jarojuda/SinglePair-Ethernet-Gateway/hardware/SinglePair-Eth-Gateway/SinglePair-Eth-Gateway.kicad_pcb

## KiCad design hardware/SinglePair-Eth-Gateway/SinglePair-Eth-Gateway.kicad_pcb (2024-01-26)

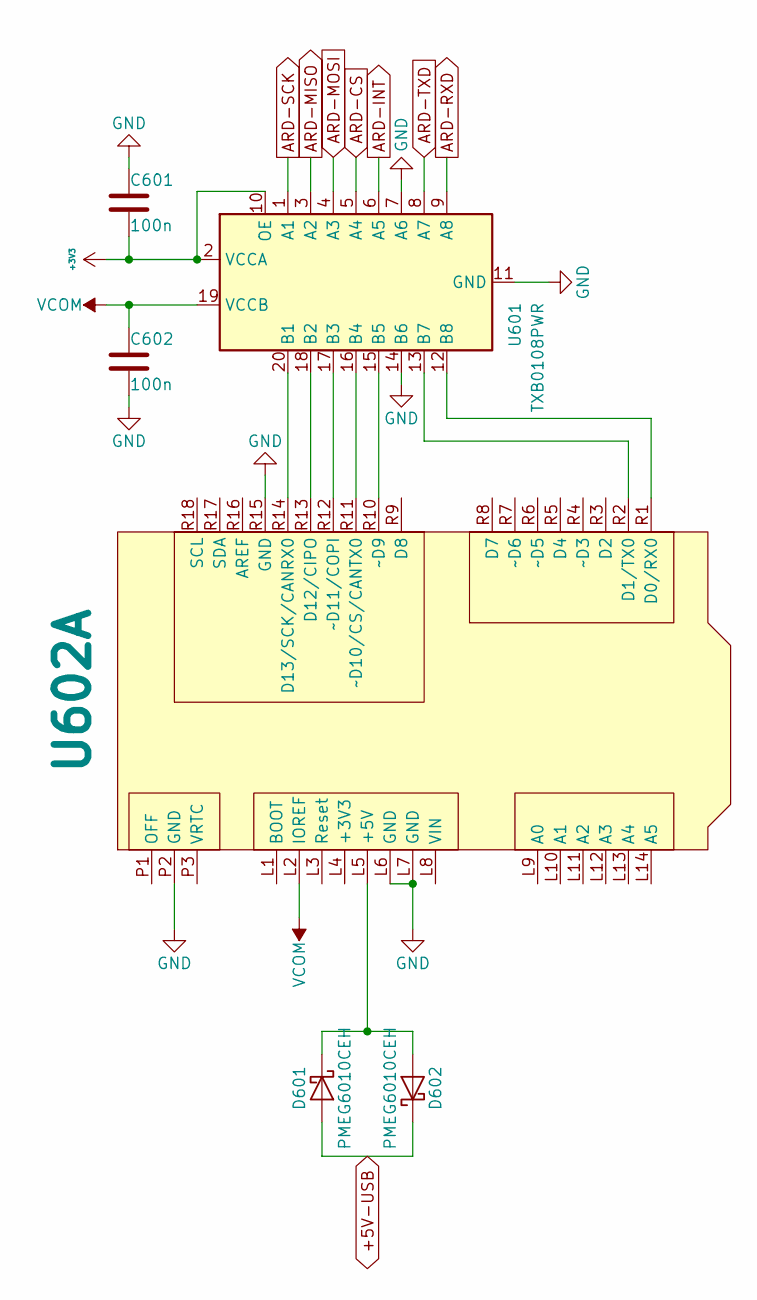
[picture p1: schematic Arduino.kicad_sch]

Parts:
C601, C602: 100n; C_0603_1608Metric
D601, D602: PMEG6010CEH; D_SOD-123F
U601: TXB0108PWR; TSSOP-20_4.4x6.5mm_P0.65mm
U602: Arduino_UNO_3_Connectors

Connections:
+3V3: C601.2, U601.2 (VCCA), U601.10 (OE); also elsewhere on the board
+5V-USB: D601.2 (A), D602.1 (K); also elsewhere on the board
ARD-CS: U601.5 (A4); also elsewhere on the board
ARD-INT: U601.6 (A5); also elsewhere on the board
ARD-MISO: U601.3 (A2); also elsewhere on the board
ARD-MOSI: U601.4 (A3); also elsewhere on the board
ARD-RXD: U601.9 (A8); also elsewhere on the board
ARD-SCK: U601.1 (A1); also elsewhere on the board
ARD-TXD: U601.8 (A7); also elsewhere on the board
GND: C601.1, C602.2, U601.7 (A6), U601.11 (GND), U601.14 (B6), U602.L6 (GND), U602.L7 (GND), U602.P2 (GND), U602.R15 (GND); also elsewhere on the board
unnamed: D601.1 (K), D602.2 (A), U602.L5 (+5V)
unnamed: U601.20 (B1), U602.R14 (D13/SCK/CANRX0)
unnamed: U601.18 (B2), U602.R13 (D12/CIPO)
unnamed: U601.17 (B3), U602.R12 (~D11/COPI)
unnamed: U601.16 (B4), U602.R11 (~D10/CS/CANTX0)
unnamed: U601.15 (B5), U602.R10 (~D9)
unnamed: U601.13 (B7), U602.R2 (D1/TX0)
unnamed: U601.12 (B8), U602.R1 (D0/RX0)
VCOM: C602.1, U601.19 (VCCB), U602.L2 (IOREF)

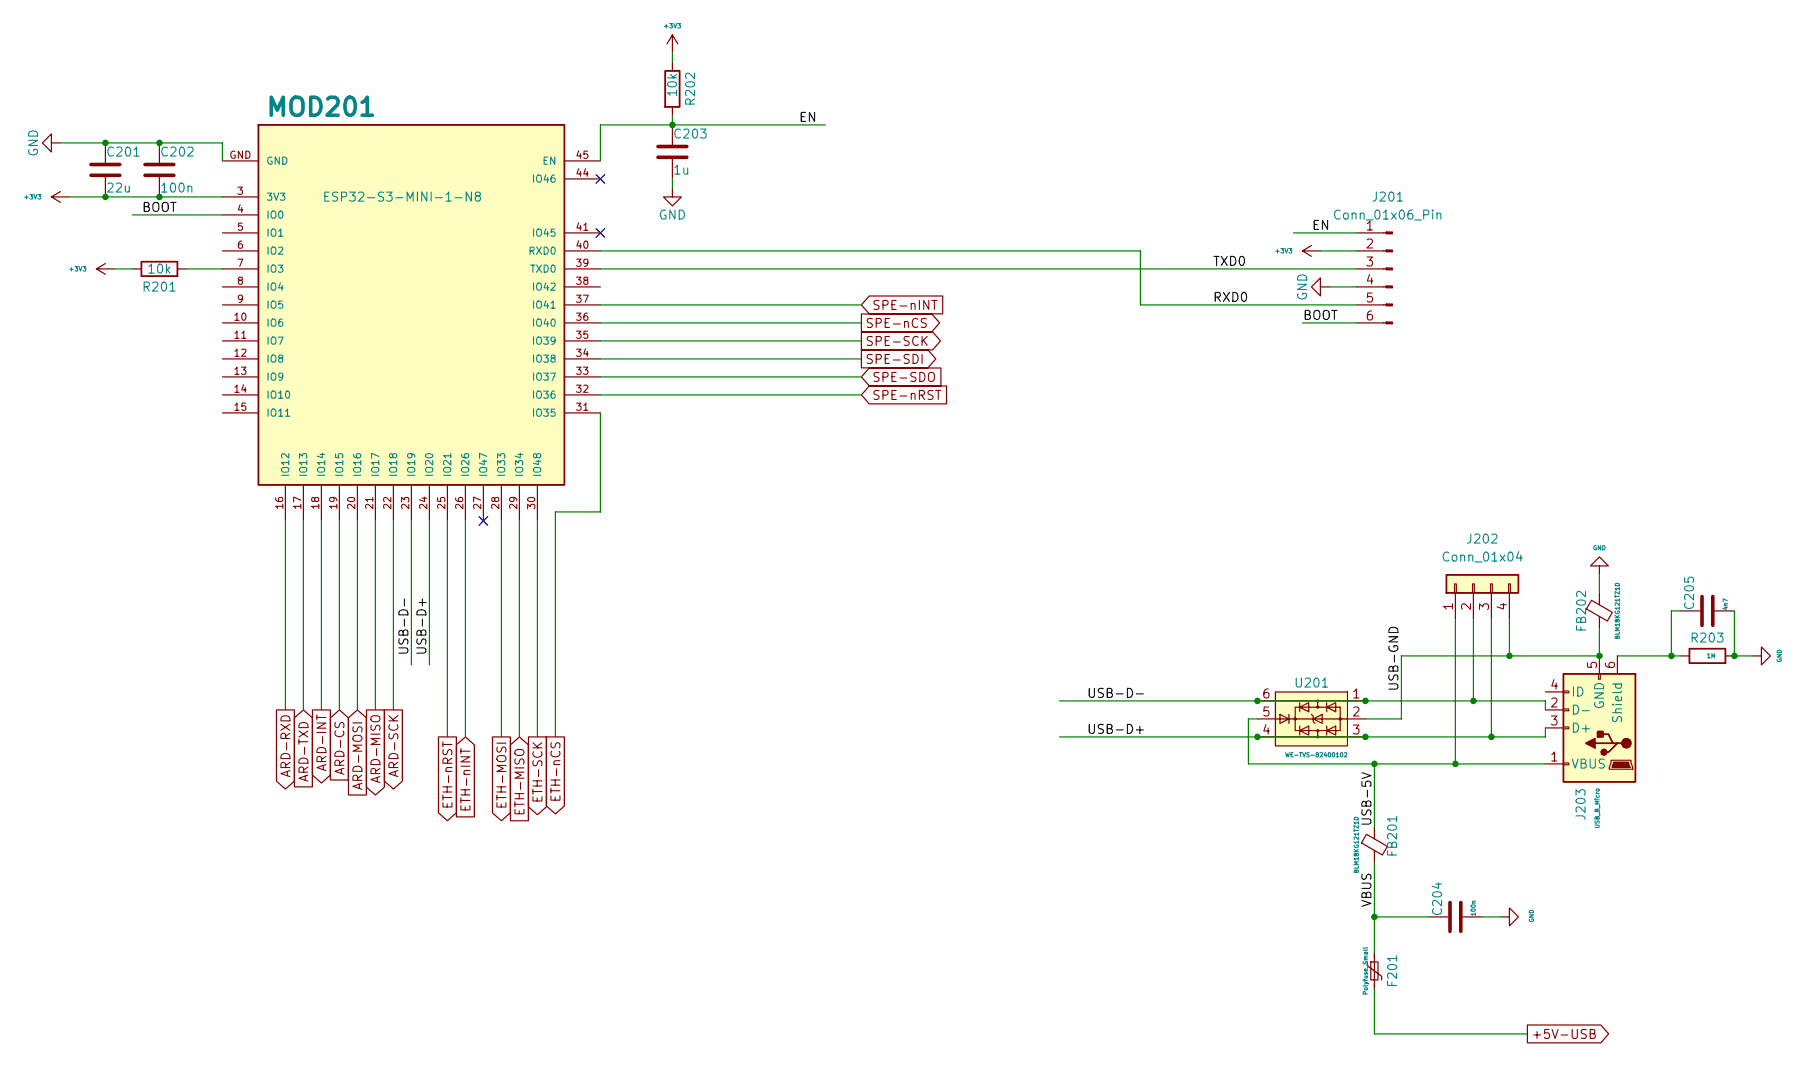
[picture p2: schematic ESP32-S3.kicad_sch]

Parts:
C201: 22u; C_0805_2012Metric
C202, C204: 100n; C_0603_1608Metric
C203: 1u; C_0603_1608Metric
C205: 4n7; C_0603_1608Metric
F201: Polyfuse_Small; Fuse_1210_3225Metric
FB201, FB202: BLM18KG121TZ1D; FB_0603_1608Metric
J201: Conn_01x06_Pin; PinHeader_1x06_P2.54mm_Vertical_SMD_Pin1Left
J202: Conn_01x04; PinSocket_1x04_P2.54mm_Vertical_SMD_Pin1Right
J203: USB_B_Micro; USB_Micro-B_Molex-105133-0001
MOD201: ESP32-S3-MINI-1-N8; XCVR_ESP32-S3-MINI-1-N8
R201, R202: 10k; R_0603_1608Metric
R203: 1M; R_0603_1608Metric
U201: WE-TVS-82400102; SOT-23-6

Connections:
+3V3: C201.2, C202.2, J201.2, MOD201.3 (3V3), R201.1, R202.1; also elsewhere on the board
+5V-USB: F201.2; also elsewhere on the board
/ESP32-S3/BOOT: J201.6, MOD201.4 (IO0)
/ESP32-S3/EN: C203.1, J201.1, MOD201.45 (EN), R202.2
/ESP32-S3/RXD0: J201.5, MOD201.40 (RXD0)
/ESP32-S3/TXD0: J201.3, MOD201.39 (TXD0)
/ESP32-S3/USB-5V: FB201.1, J202.1, J203.1 (VBUS), U201.5
/ESP32-S3/USB-D+: J202.3, J203.3 (D+), MOD201.24 (IO20), U201.3, U201.4
/ESP32-S3/USB-D-: J202.2, J203.2 (D-), MOD201.23 (IO19), U201.1, U201.6
/ESP32-S3/USB-GND: FB202.2, J202.4, J203.5 (GND), U201.2
/ESP32-S3/VBUS: C204.1, F201.1, FB201.2
ARD-CS: MOD201.19 (IO15); also elsewhere on the board
ARD-INT: MOD201.18 (IO14); also elsewhere on the board
ARD-MISO: MOD201.21 (IO17); also elsewhere on the board
ARD-MOSI: MOD201.20 (IO16); also elsewhere on the board
ARD-RXD: MOD201.16 (IO12); also elsewhere on the board
ARD-SCK: MOD201.22 (IO18); also elsewhere on the board
ARD-TXD: MOD201.17 (IO13); also elsewhere on the board
ETH-MISO: MOD201.29 (IO34); also elsewhere on the board
ETH-MOSI: MOD201.28 (IO33); also elsewhere on the board
ETH-SCK: MOD201.30 (IO48); also elsewhere on the board
ETH-nCS: MOD201.31 (IO35); also elsewhere on the board
ETH-nINT: MOD201.26 (IO26); also elsewhere on the board
ETH-nRST: MOD201.25 (IO21); also elsewhere on the board
GND: C201.1, C202.1, C203.2, C204.2, C205.2, FB202.1, J201.4, MOD201.GND, R203.2; also elsewhere on the board
unnamed: C205.1, J203.6 (Shield), R203.1
unnamed: MOD201.7 (IO3), R201.2
SPE-SCK: MOD201.35 (IO39); also elsewhere on the board
SPE-SDI: MOD201.34 (IO38); also elsewhere on the board
SPE-SDO: MOD201.33 (IO37); also elsewhere on the board
SPE-nCS: MOD201.36 (IO40); also elsewhere on the board
SPE-nINT: MOD201.37 (IO41); also elsewhere on the board
SPE-nRST: MOD201.32 (IO36); also elsewhere on the board

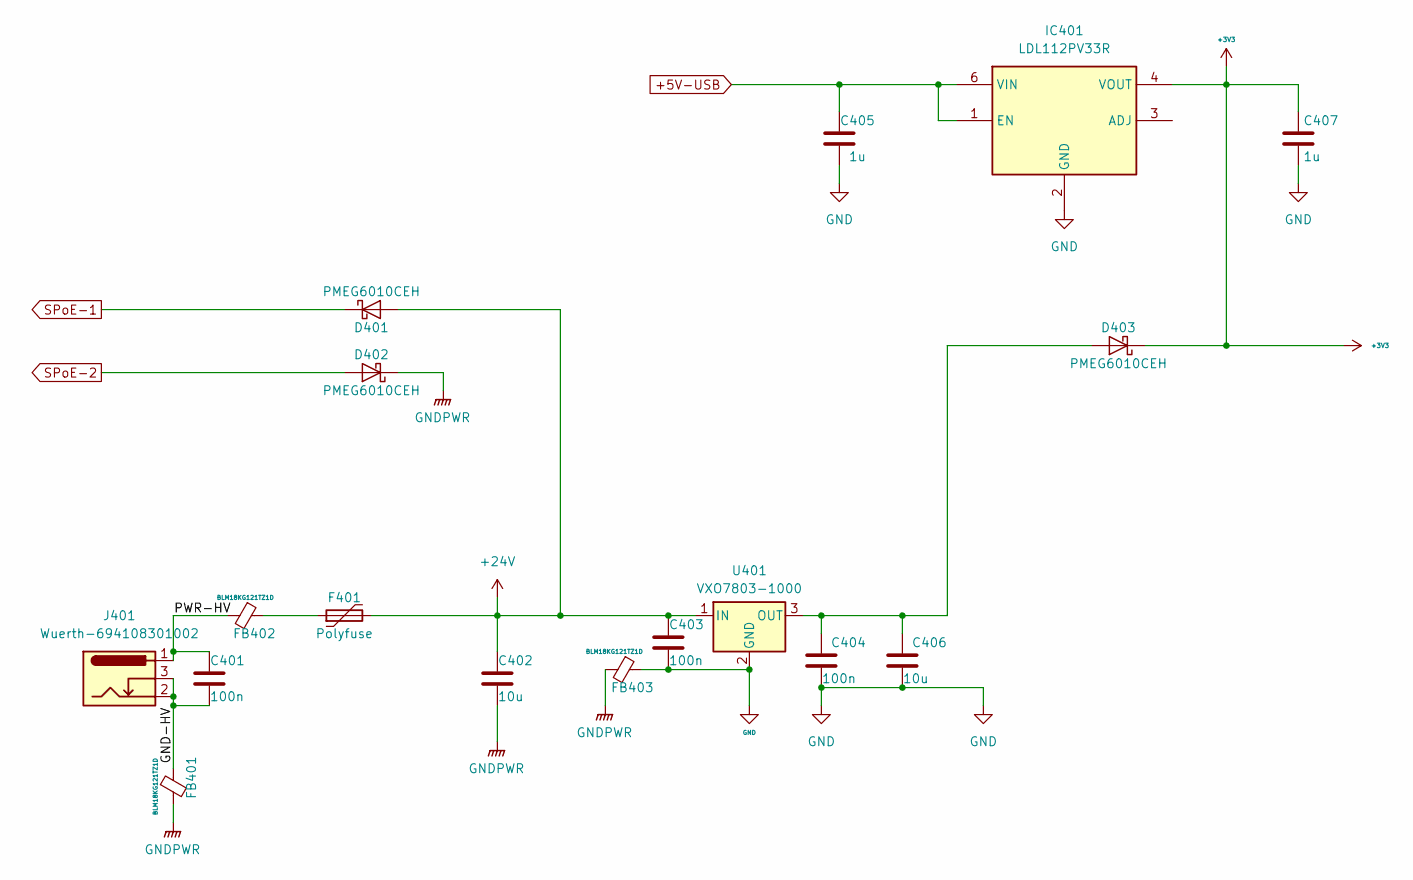
[picture p3: schematic PowerSupply.kicad_sch]

Parts:
C401, C403, C404: 100n; C_0603_1608Metric
C402, C406: 10u; C_0805_2012Metric
C405, C407: 1u; C_0603_1608Metric
D401, D402, D403: PMEG6010CEH; D_SOD-123F
F401: Polyfuse; Fuse_1210_3225Metric
FB401, FB402, FB403: BLM18KG121TZ1D; FB_0603_1608Metric
IC401: LDL112PV33R; SON95P300X300X100-7N-D; Manufacturer_Part_Number LDL112PV33R; Mouser Part Number 511-LDL112PV33R
J401: Wuerth-694108301002; BarrelJack_Wuerth_6941xx301002
U401: VXO7803-1000; TO-220-3_Vertical

Connections:
+3V3: C407.1, D403.1 (K), IC401.4 (VOUT); also elsewhere on the board
+5V-USB: C405.1, IC401.1 (EN), IC401.6 (VIN); also elsewhere on the board
+24V: C402.1, C403.1, D401.2 (A), F401.2, U401.1 (IN)
/PowerSupply/GND-HV: C401.2, FB401.1, J401.2, J401.3
/PowerSupply/PWR-HV: C401.1, FB402.2, J401.1
GND: C403.2, C404.2, C405.2, C406.2, C407.2, FB403.1, IC401.2 (GND), IC401.7 (EP), U401.2 (GND); also elsewhere on the board
GNDPWR: C402.2, D402.1 (K), FB401.2, FB403.2; also elsewhere on the board
unnamed: C404.1, C406.1, D403.2 (A), U401.3 (OUT)
unnamed: F401.1, FB402.1
SPoE-1: D401.1 (K); also elsewhere on the board
SPoE-2: D402.2 (A); also elsewhere on the board

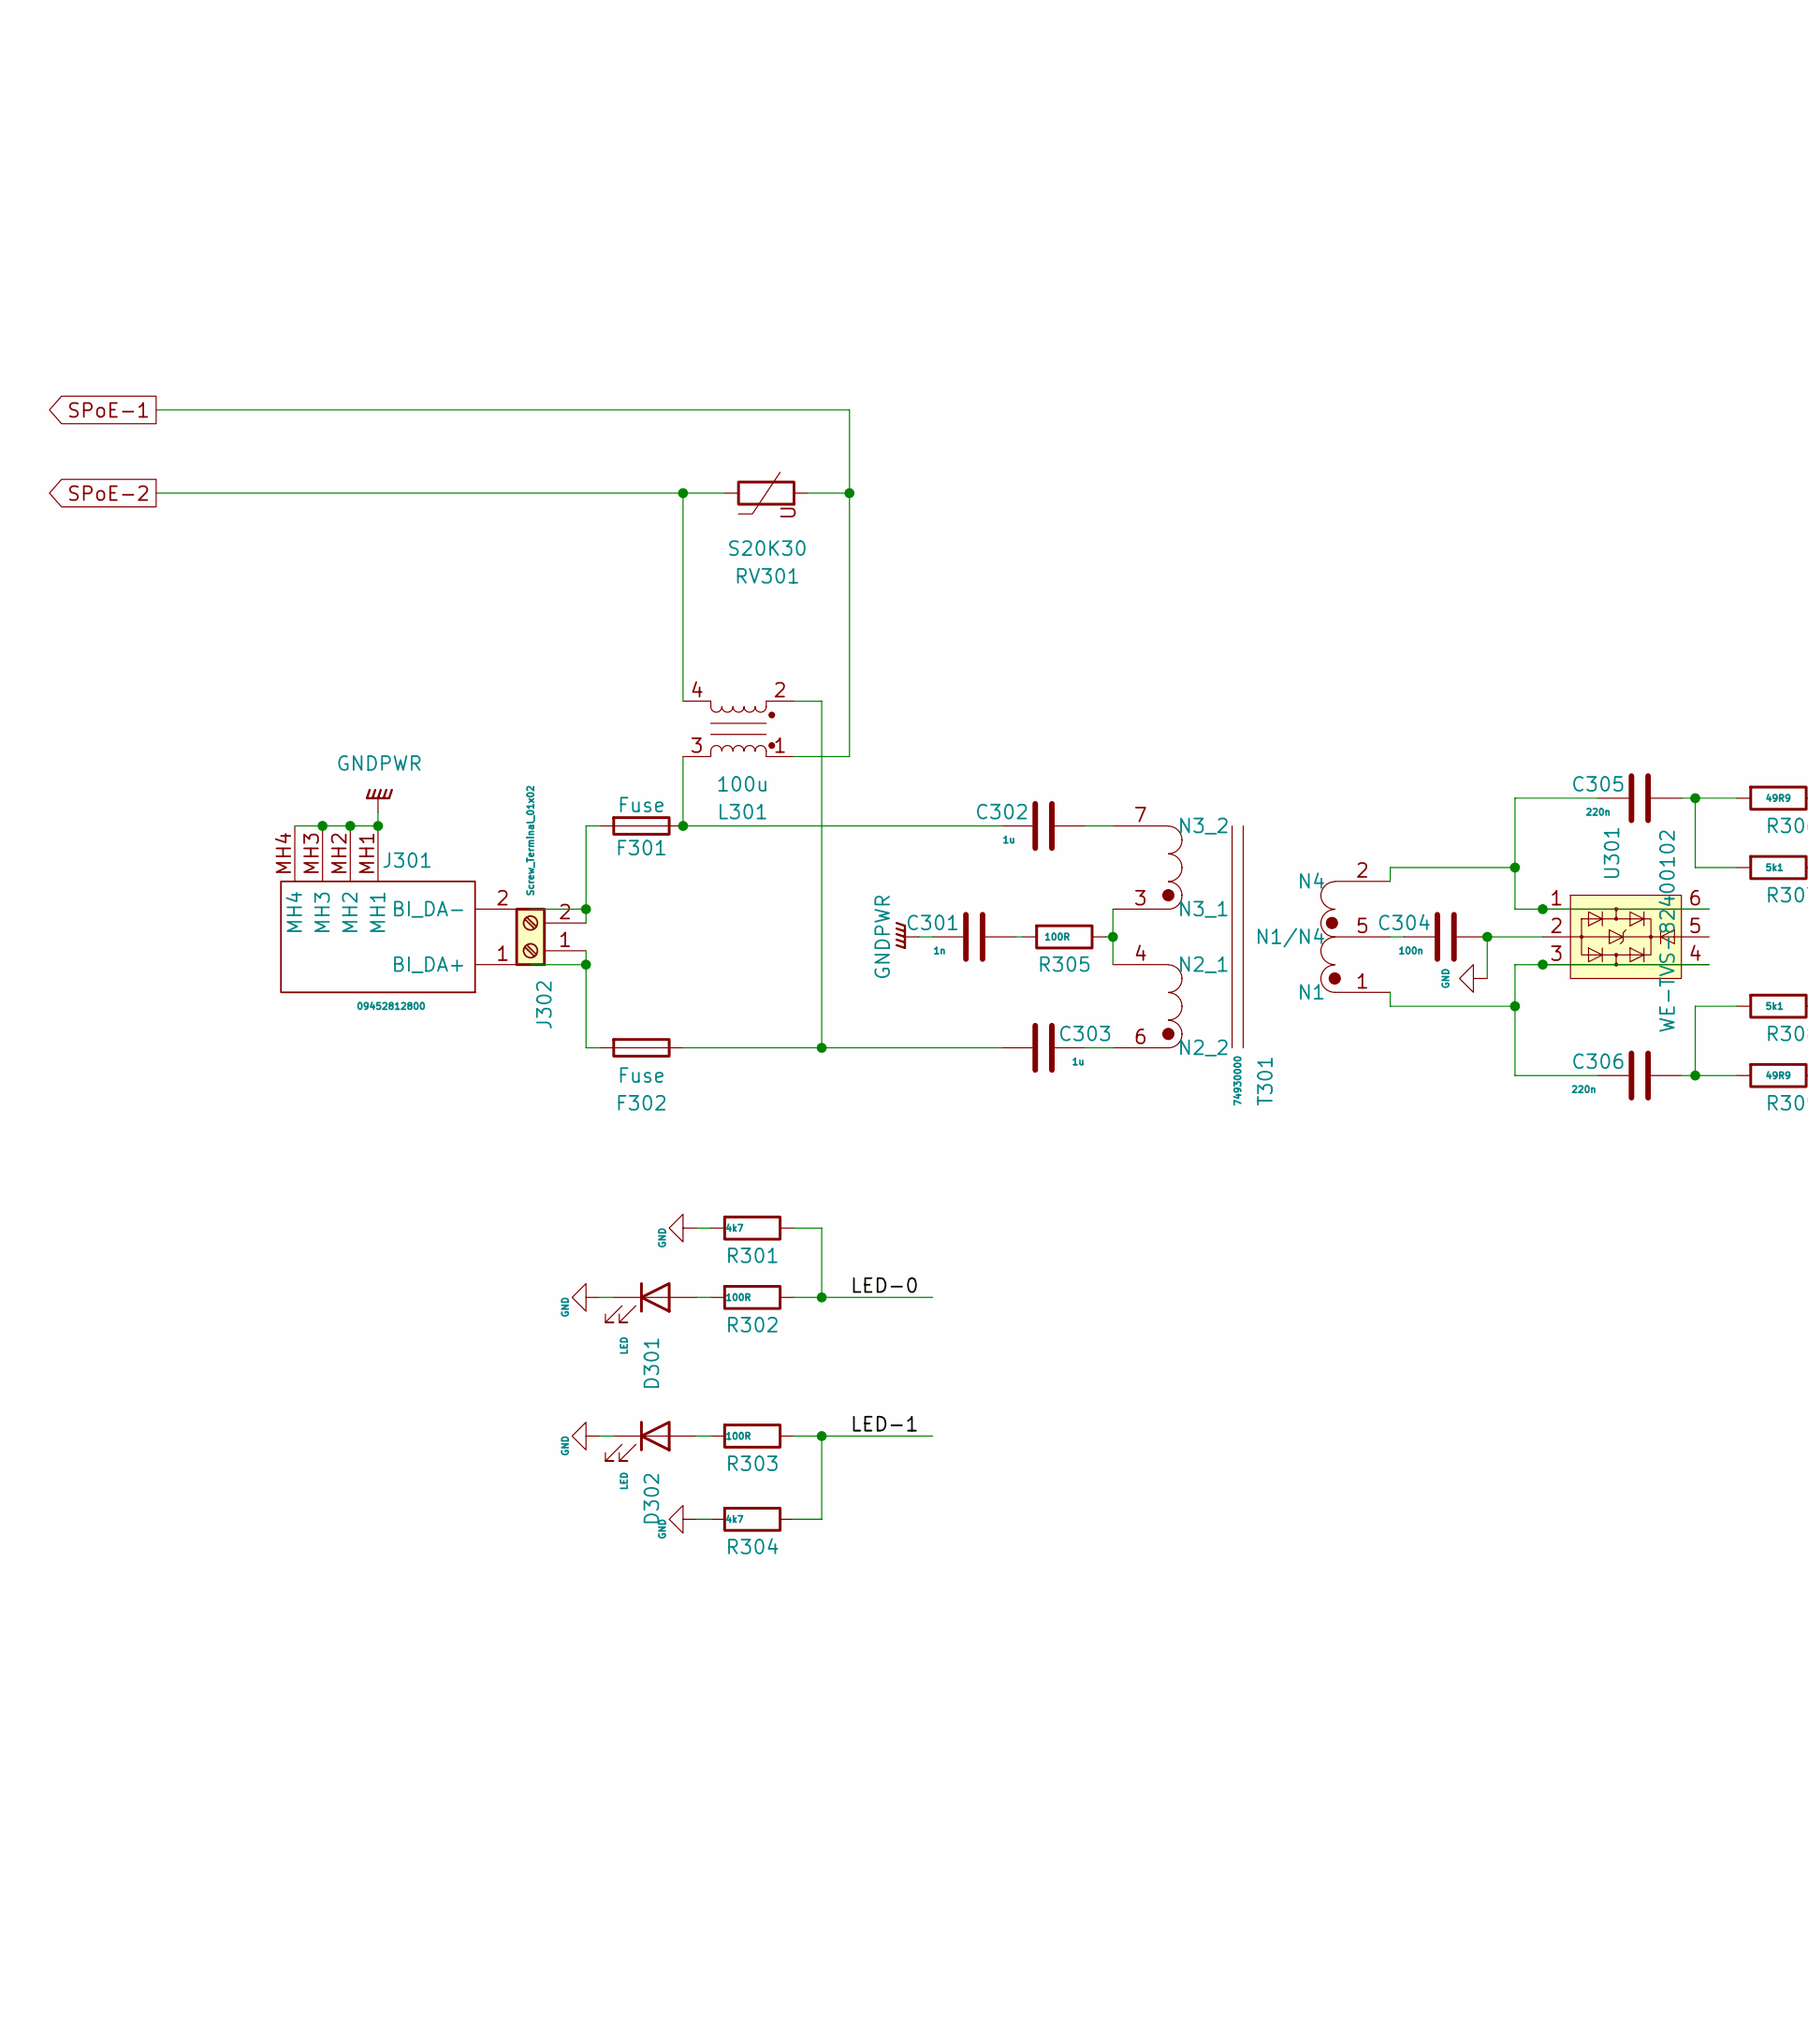
[picture p4: schematic ADIN1110.kicad_sch, part in row 1, column 1]

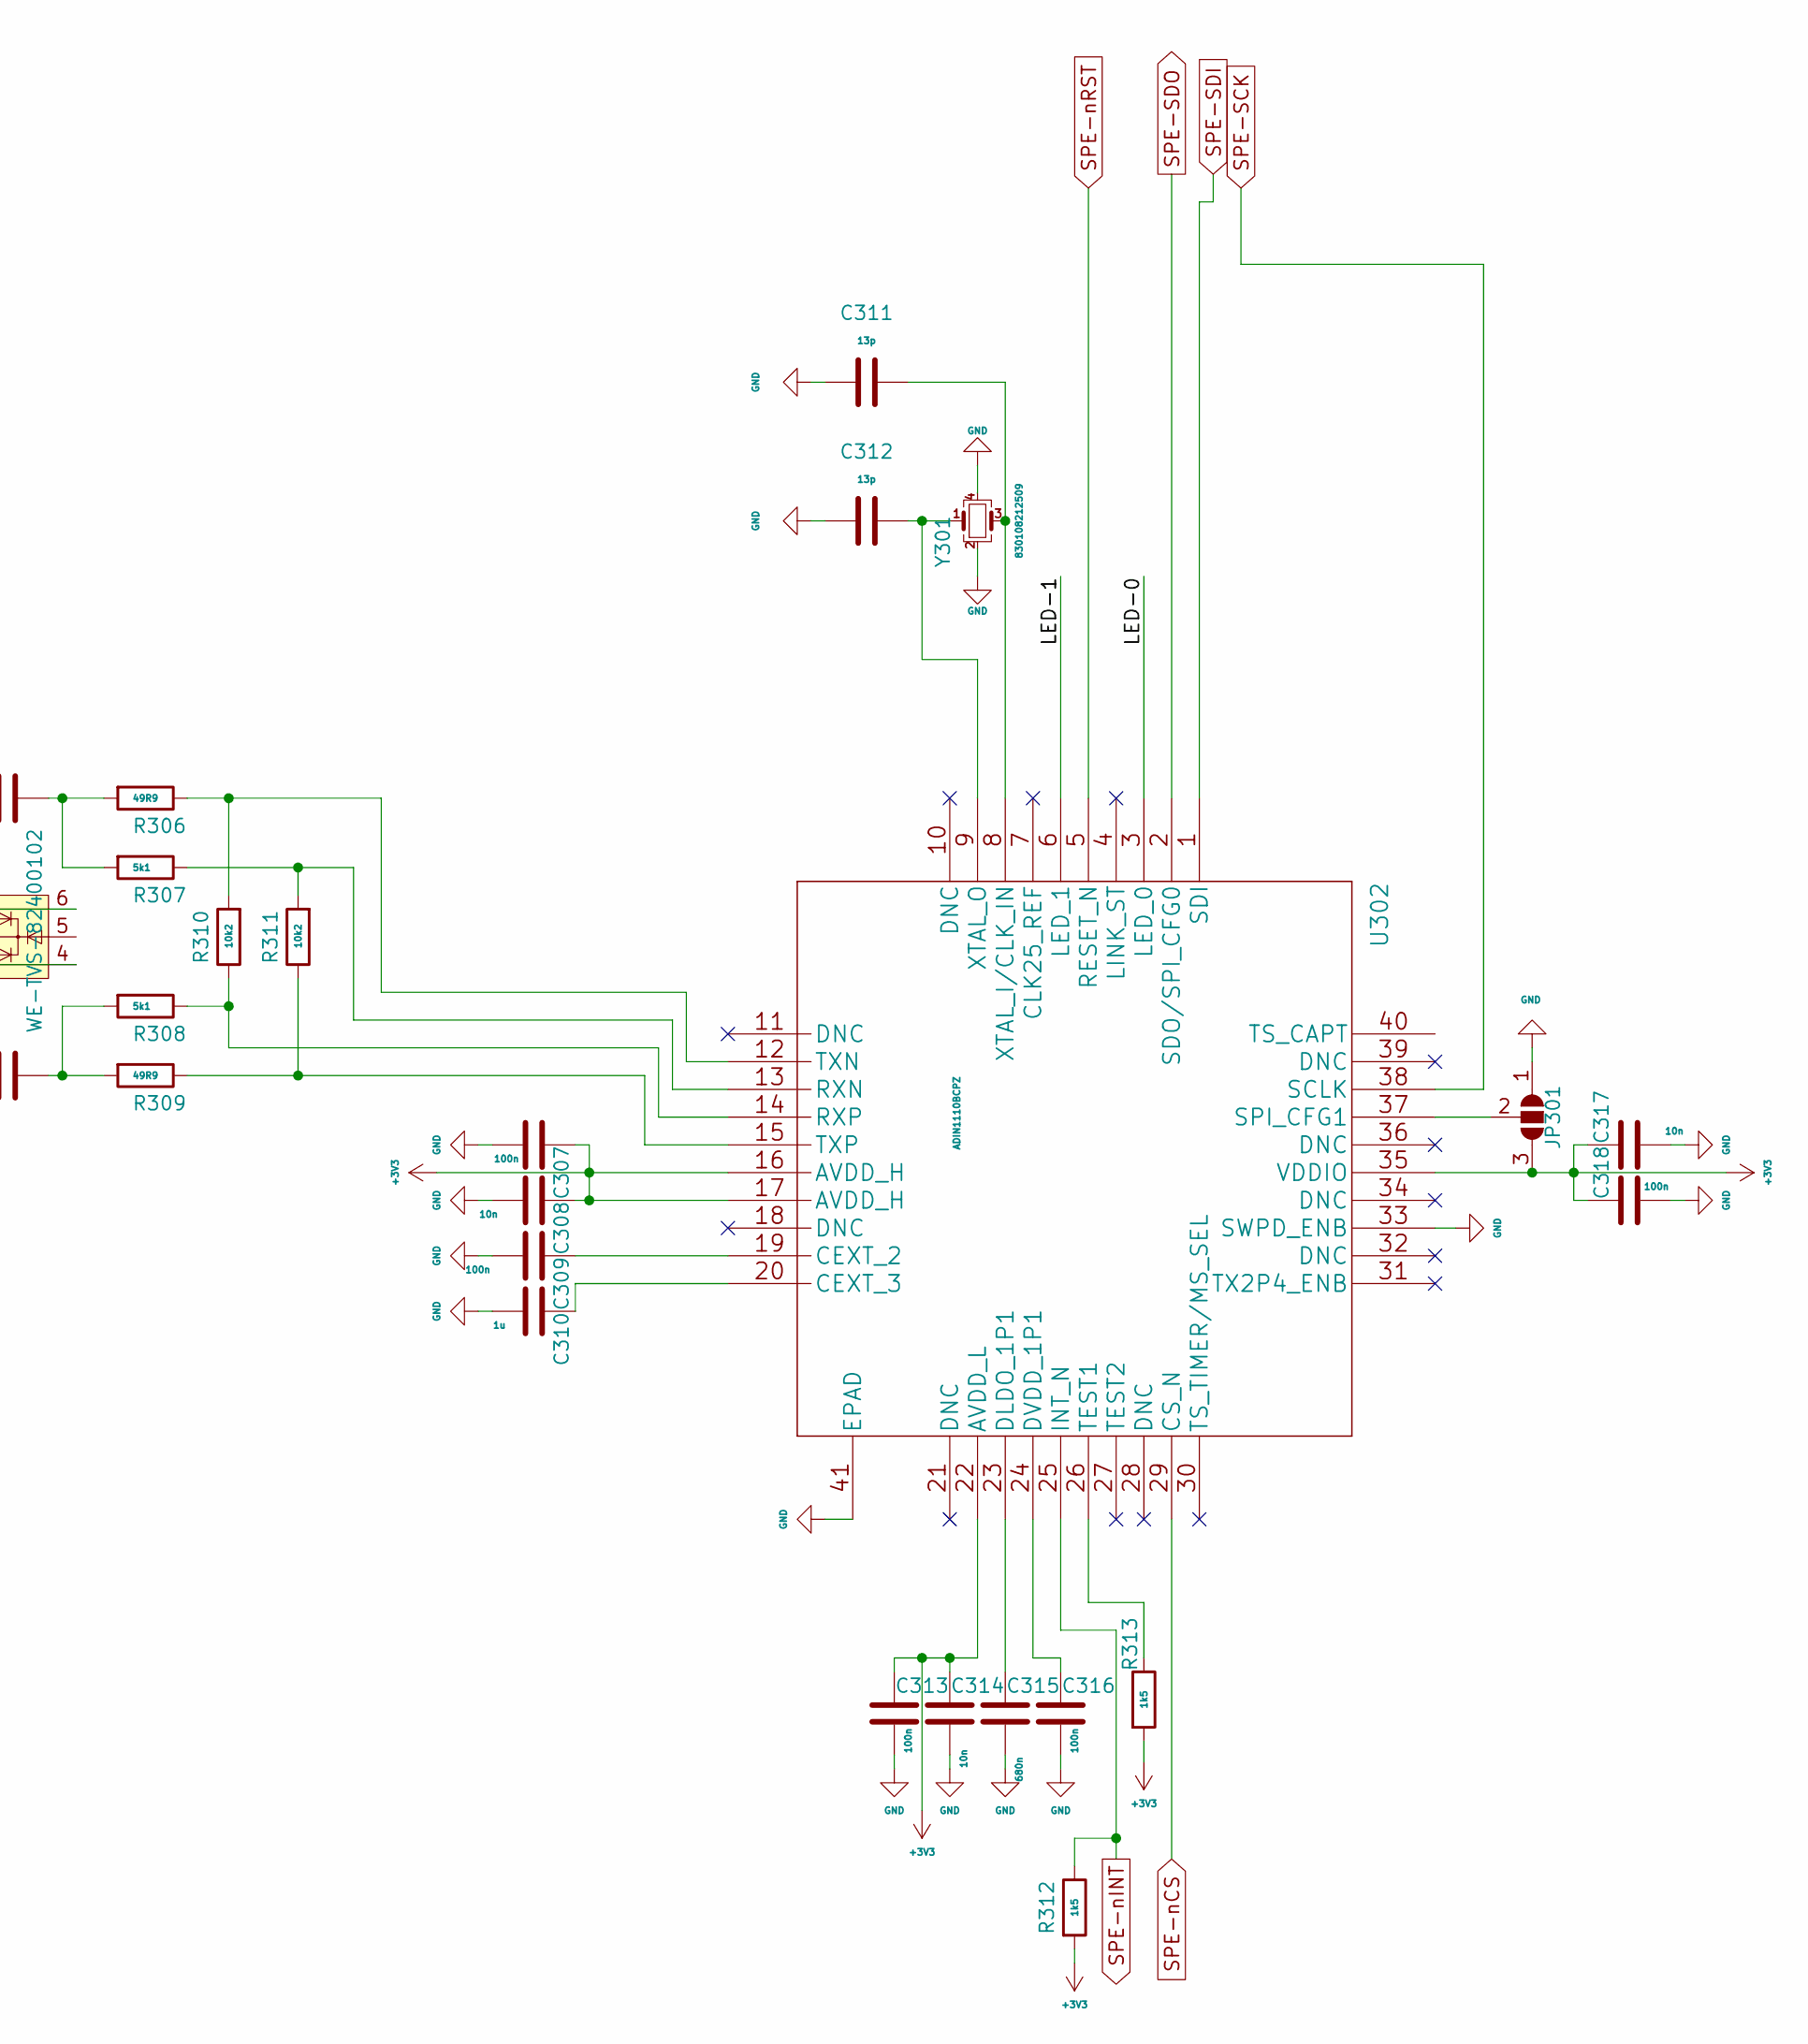
[picture p5: schematic ADIN1110.kicad_sch, part in row 1, column 2]

Parts:
C301: 1n; C_1206_3216Metric
C302, C303, C310: 1u; C_0603_1608Metric
C304, C307, C309, C313, C316, C318: 100n; C_0603_1608Metric
C305, C306: 220n; C_0603_1608Metric
C308, C314, C317: 10n; C_0603_1608Metric
C311, C312: 13p; C_0603_1608Metric
C315: 680n; C_0603_1608Metric
D301, D302: LED; LED_0603_1608Metric
F301, F302: Fuse; Fuseholder_Cylinder-5x20mm_Schurter_0031_8201_Horizontal_Op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
J301: 09452812800; Manufacturer_Part_Number 09452812800; Mouser Part Number 617-09452812800
J302: Screw_Terminal_01x02; TerminalBlock_Altech_AK300-2_P5.00mm
JP301: SolderJumper_3_Open; SolderJumper-3_P1.3mm_Open_RoundedPad1.0x1.5mm
L301: 100u; 744871101
R301, R304: 4k7; R_0603_1608Metric
R302, R303, R305: 100R; R_0603_1608Metric
R306, R309: 49R9; R_0603_1608Metric
R307, R308: 5k1; R_0603_1608Metric
R310, R311: 10k2; R_0603_1608Metric
R312, R313: 1k5; R_0603_1608Metric
RV301: S20K30; RV_Disc_D21.5mm_W4.3mm_P10mm
T301: 74930000; Manufacturer_Part_Number 74930000; Mouser Part Number 710-74930000
U301: WE-TVS-82400102; SOT-23-6
U302: ADIN1110BCPZ; ADIN1110
Y301: 830108212509; Crystal_SMD_2016-4Pin_2.0x1.6mm

Connections:
+3V3: C307.1, C308.1, C313.1, C314.1, C317.1, C318.1, JP301.3 (B), R312.2, R313.2, U302.16 (AVDD_H), U302.17 (AVDD_H), U302.22 (AVDD_L), U302.35 (VDDIO); also elsewhere on the board
/ADIN1110/LED-0: R301.1, R302.1, U302.3 (LED_0)
/ADIN1110/LED-1: R303.1, R304.1, U302.6 (LED_1)
GND: C304.1, C307.2, C308.2, C309.2, C310.2, C311.1, C312.2, C313.2, C314.2, C315.2, C316.2, C317.2, C318.2, D301.1 (K), D302.1 (K), JP301.1 (A), R301.2, R304.2, U301.2, U302.33 (SWPD_ENB), U302.41 (EPAD), Y301.2, Y301.4; also elsewhere on the board
GNDPWR: C301.2, J301.MH1, J301.MH2, J301.MH3, J301.MH4; also elsewhere on the board
unnamed: C301.1, R305.2
unnamed: C302.2, F301.1, L301.3
unnamed: C303.1, F302.1, L301.2
unnamed: C305.1, R306.2, R307.2
unnamed: C306.2, R308.2, R309.2
unnamed: D301.2 (A), R302.2
unnamed: D302.2 (A), R303.2
unnamed: F302.2, J301.1 (BI_DA+), J302.1
unnamed: F301.2, J301.2 (BI_DA-), J302.2
unnamed: JP301.2 (C), U302.37 (SPI_CFG1)
unnamed: C306.1, T301.1 (N1), U301.3, U301.4
unnamed: C304.2, T301.5 (N1/N4)
unnamed: R305.1, T301.3 (N3_1), T301.4 (N2_1)
unnamed: C303.2, T301.6 (N2_2)
unnamed: C302.1, T301.7 (N3_2)
unnamed: C305.2, T301.2 (N4), U301.1, U301.6
unnamed: C309.1, U302.19 (CEXT_2)
unnamed: C310.1, U302.20 (CEXT_3)
unnamed: C315.1, U302.23 (DLDO_1P1)
unnamed: C316.1, U302.24 (DVDD_1P1)
unnamed: R307.1, R311.2, U302.13 (RXN)
unnamed: R308.1, R310.1, U302.14 (RXP)
unnamed: R313.1, U302.26 (TEST1)
unnamed: R306.1, R310.2, U302.12 (TXN)
unnamed: R309.1, R311.1, U302.15 (TXP)
unnamed: C311.2, U302.8 (XTAL_I/CLK_IN), Y301.3
unnamed: C312.1, U302.9 (XTAL_O), Y301.1
SPE-SCK: U302.38 (SCLK); also elsewhere on the board
SPE-SDI: U302.1 (SDI); also elsewhere on the board
SPE-SDO: U302.2 (SDO/SPI_CFG0); also elsewhere on the board
SPE-nCS: U302.29 (CS_N); also elsewhere on the board
SPE-nINT: R312.1, U302.25 (INT_N); also elsewhere on the board
SPE-nRST: U302.5 (RESET_N); also elsewhere on the board
SPoE-1: L301.1, RV301.2; also elsewhere on the board
SPoE-2: L301.4, RV301.1; also elsewhere on the board
