jarojuda/SinglePair-Ethernet-Gateway/hardware/SinglePair-Eth-Gateway/SinglePair-Eth-Gateway.kicad_pcb

## KiCad design hardware/SinglePair-Eth-Gateway/SinglePair-Eth-Gateway.kicad_pcb (continued)

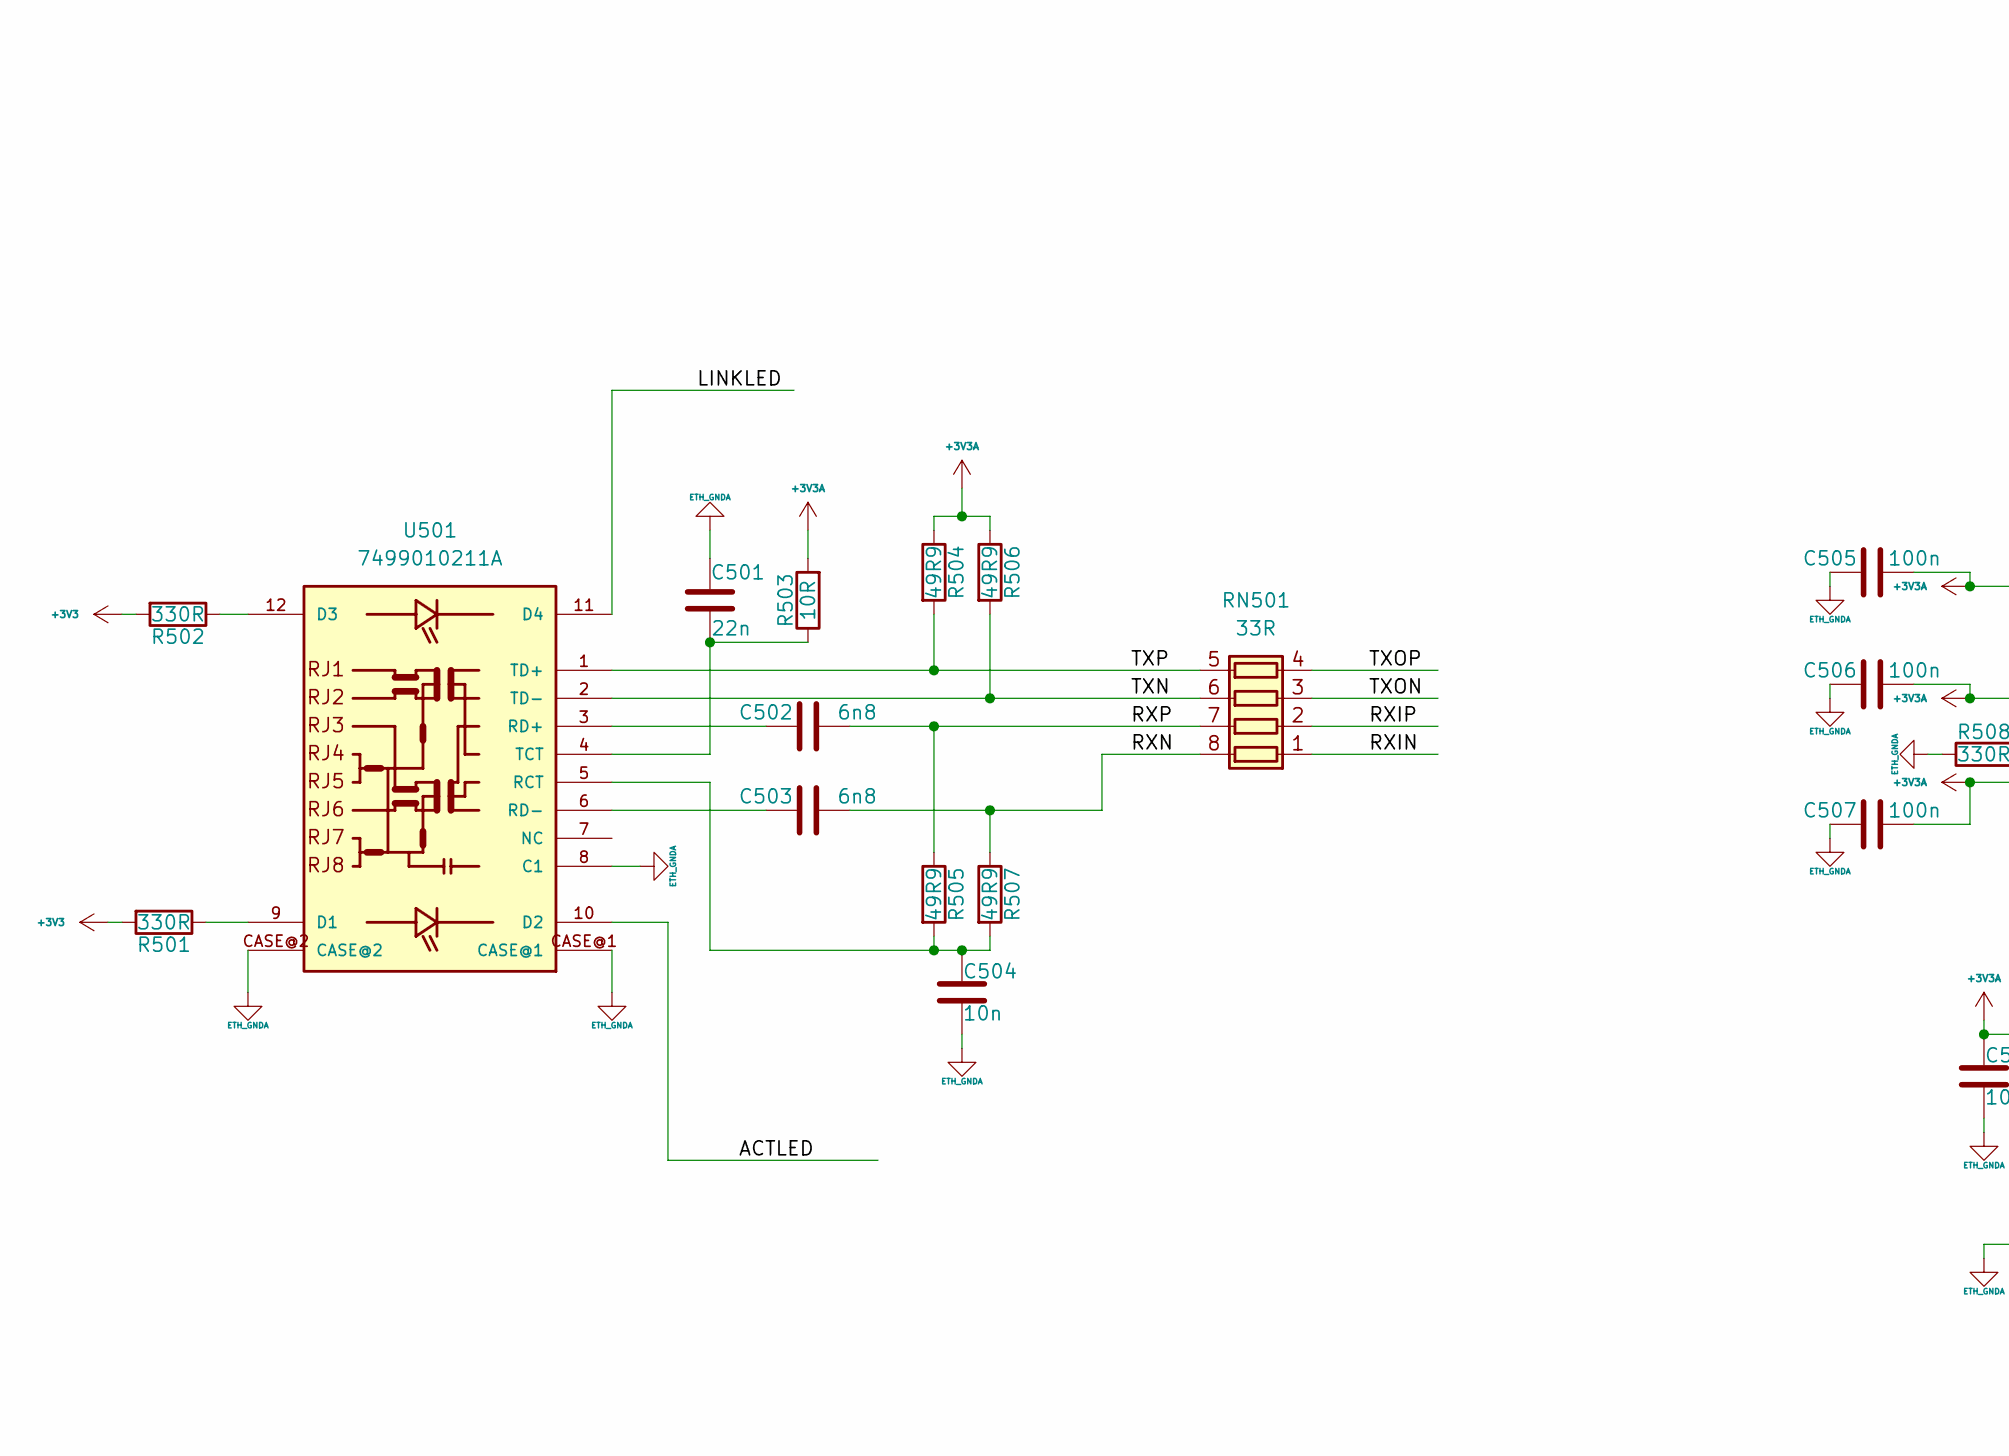
[picture p6: schematic W5500.kicad_sch, part in row 1, column 1]

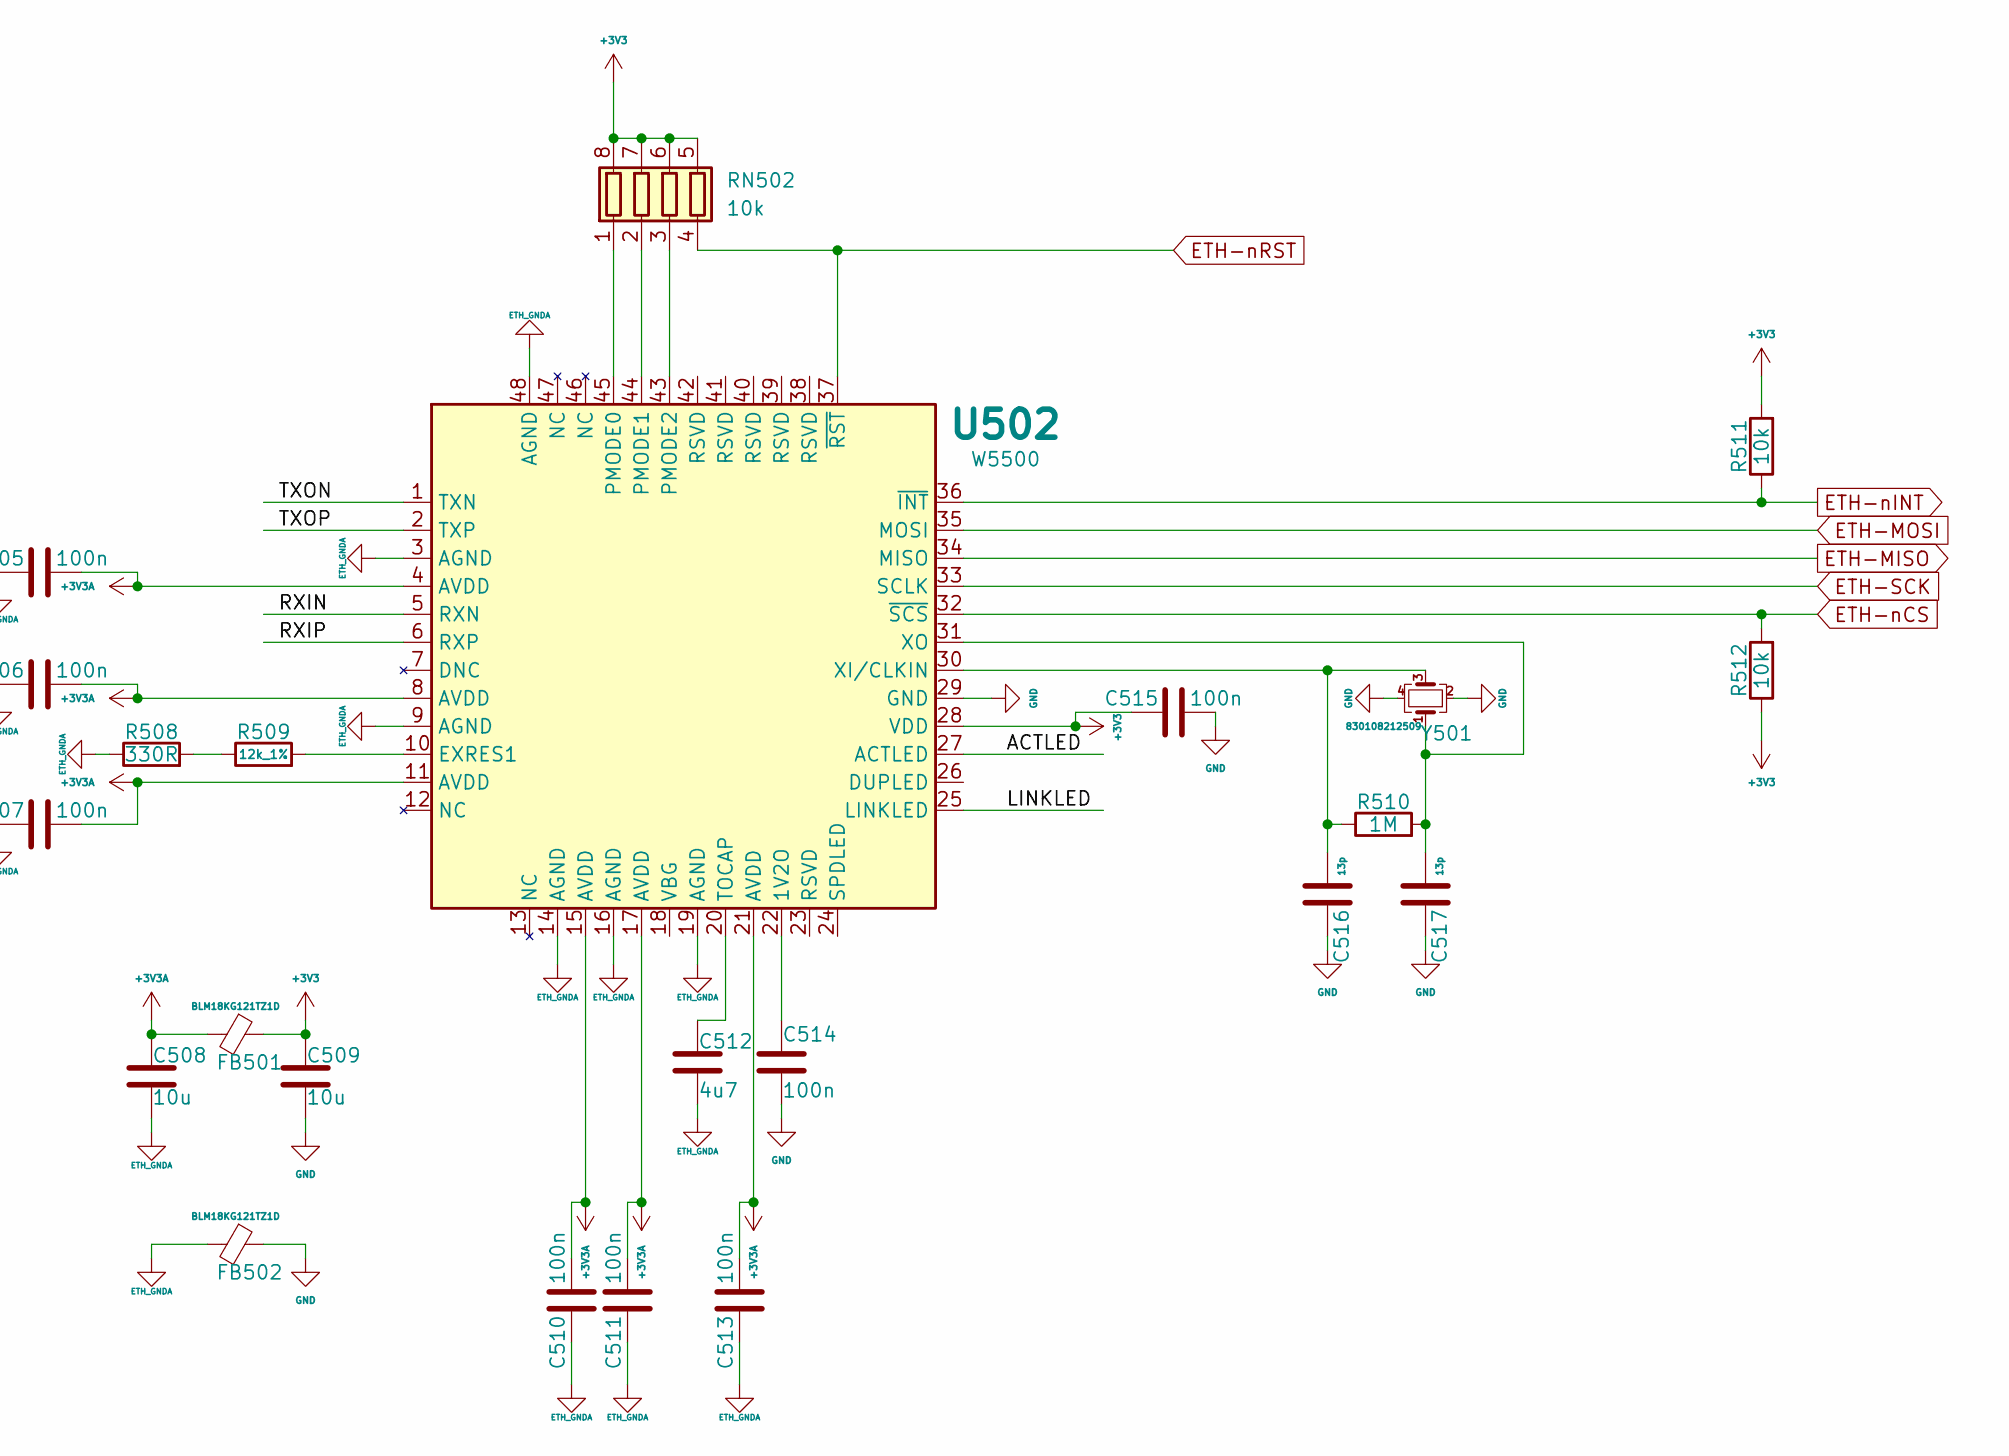
[picture p7: schematic W5500.kicad_sch, part in row 1, column 2]

Parts:
C501: 22n; C_0603_1608Metric
C502, C503: 6n8; C_0603_1608Metric
C504: 10n; C_0603_1608Metric
C505, C506, C507, C510, C511, C513, C514, C515: 100n; C_0603_1608Metric
C508, C509: 10u; C_0805_2012Metric
C512: 4u7; C_0603_1608Metric
C516, C517: 13p; C_0603_1608Metric
FB501, FB502: BLM18KG121TZ1D; FB_0603_1608Metric
R501, R502, R508: 330R; R_0603_1608Metric
R503: 10R; R_0603_1608Metric
R504, R505, R506, R507: 49R9; R_0603_1608Metric
R509: 12k_1%; R_0603_1608Metric
R510: 1M; R_0603_1608Metric
R511, R512: 10k; R_0603_1608Metric
RN501: 33R; R_Array_Concave_4x0603
RN502: 10k; R_Array_Concave_4x0603
U501: 7499010211A
U502: W5500; LQFP-48_7x7mm_P0.5mm
Y501: 830108212509; Crystal_SMD_2016-4Pin_2.0x1.6mm

Connections:
+3V3: C509.1, C515.1, FB501.1, R501.2, R502.2, R511.2, R512.1, RN502.5 (R4.2), RN502.6 (R3.2), RN502.7 (R2.2), RN502.8 (R1.2), U502.28 (VDD); also elsewhere on the board
+3V3A: C505.2, C506.2, C507.2, C508.1, C510.2, C511.2, C513.2, FB501.2, R503.2, R504.1, R506.1, U502.4 (AVDD), U502.8 (AVDD), U502.11 (AVDD), U502.15 (AVDD), U502.17 (AVDD), U502.21 (AVDD)
/Wiznet-W5500/ACTLED: U501.10 (D2), U502.27 (ACTLED)
/Wiznet-W5500/LINKLED: U501.11 (D4), U502.25 (LINKLED)
/Wiznet-W5500/RXIN: RN501.1 (R1.1), U502.5 (RXN)
/Wiznet-W5500/RXIP: RN501.2 (R2.1), U502.6 (RXP)
/Wiznet-W5500/RXN: C503.2, R507.1, RN501.8 (R1.2)
/Wiznet-W5500/RXP: C502.2, R505.1, RN501.7 (R2.2)
/Wiznet-W5500/TXN: R506.2, RN501.6 (R3.2), U501.2 (TD-)
/Wiznet-W5500/TXON: RN501.3 (R3.1), U502.1 (TXN)
/Wiznet-W5500/TXOP: RN501.4 (R4.1), U502.2 (TXP)
/Wiznet-W5500/TXP: R504.2, RN501.5 (R4.2), U501.1 (TD+)
ETH-MISO: U502.34 (MISO); also elsewhere on the board
ETH-MOSI: U502.35 (MOSI); also elsewhere on the board
ETH-SCK: U502.33 (SCLK); also elsewhere on the board
ETH-nCS: R512.2, U502.32 (~SCS); also elsewhere on the board
ETH-nINT: R511.1, U502.36 (~INT); also elsewhere on the board
ETH-nRST: RN502.4 (R4.1), U502.37 (~RST); also elsewhere on the board
ETHGNDA: C501.2, C504.2, C505.1, C506.1, C507.1, C508.2, C510.1, C511.1, C512.2, C513.1, FB502.2, R508.1, U501.8 (C1), U501.CASE@1, U501.CASE@2, U502.3 (AGND), U502.9 (AGND), U502.14 (AGND), U502.16 (AGND), U502.19 (AGND), U502.48 (AGND)
GND: C509.2, C514.2, C515.2, C516.1, C517.2, FB502.1, U502.29 (GND), Y501.2, Y501.4; also elsewhere on the board
unnamed: R508.2, R509.1
unnamed: RN502.1 (R1.1), U502.45 (PMODE0)
unnamed: RN502.2 (R2.1), U502.44 (PMODE1)
unnamed: RN502.3 (R3.1), U502.43 (PMODE2)
unnamed: R501.1, U501.9 (D1)
unnamed: R502.1, U501.12 (D3)
unnamed: C504.1, R505.2, R507.2, U501.5 (RCT)
unnamed: C502.1, U501.3 (RD+)
unnamed: C503.1, U501.6 (RD-)
unnamed: C501.1, R503.1, U501.4 (TCT)
unnamed: C514.1, U502.22 (1V2O)
unnamed: R509.2, U502.10 (EXRES1)
unnamed: C512.1, U502.20 (TOCAP)
unnamed: C516.2, R510.1, U502.30 (XI/CLKIN), Y501.3
unnamed: C517.1, R510.2, U502.31 (XO), Y501.1

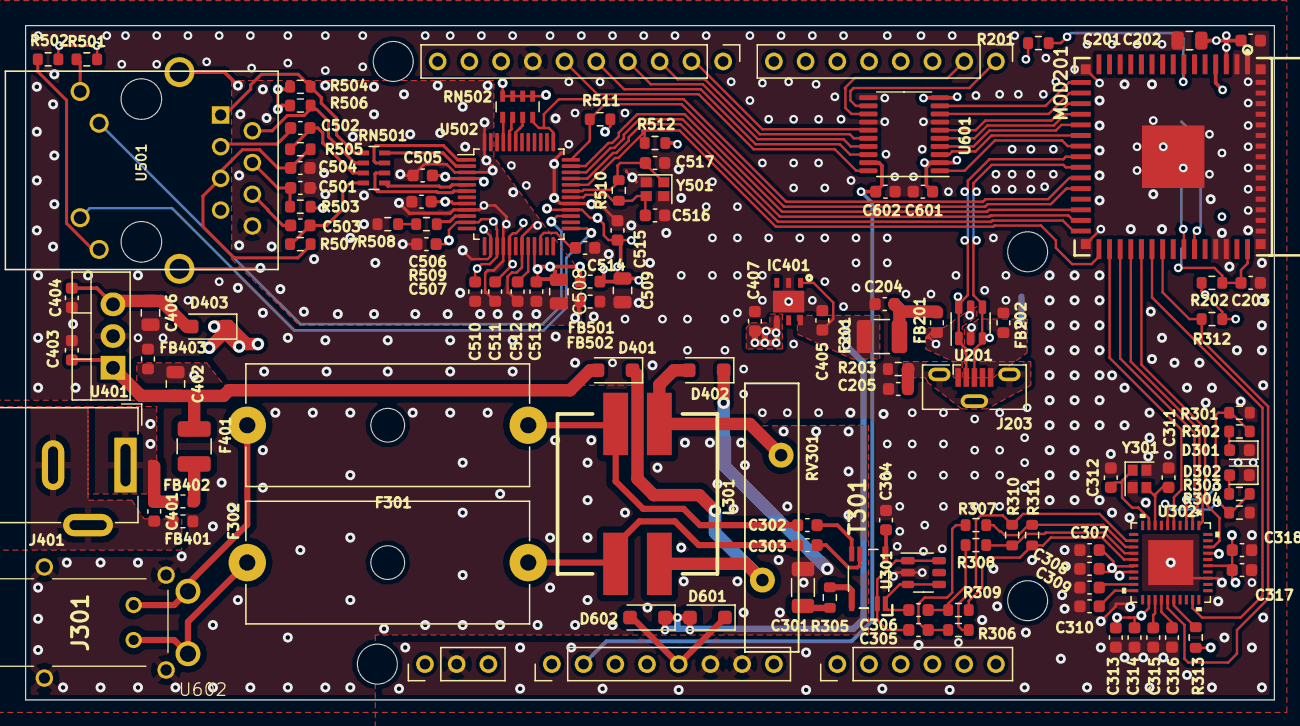
[picture p8: board SinglePair-Eth-Gateway.kicad_pcb from above]

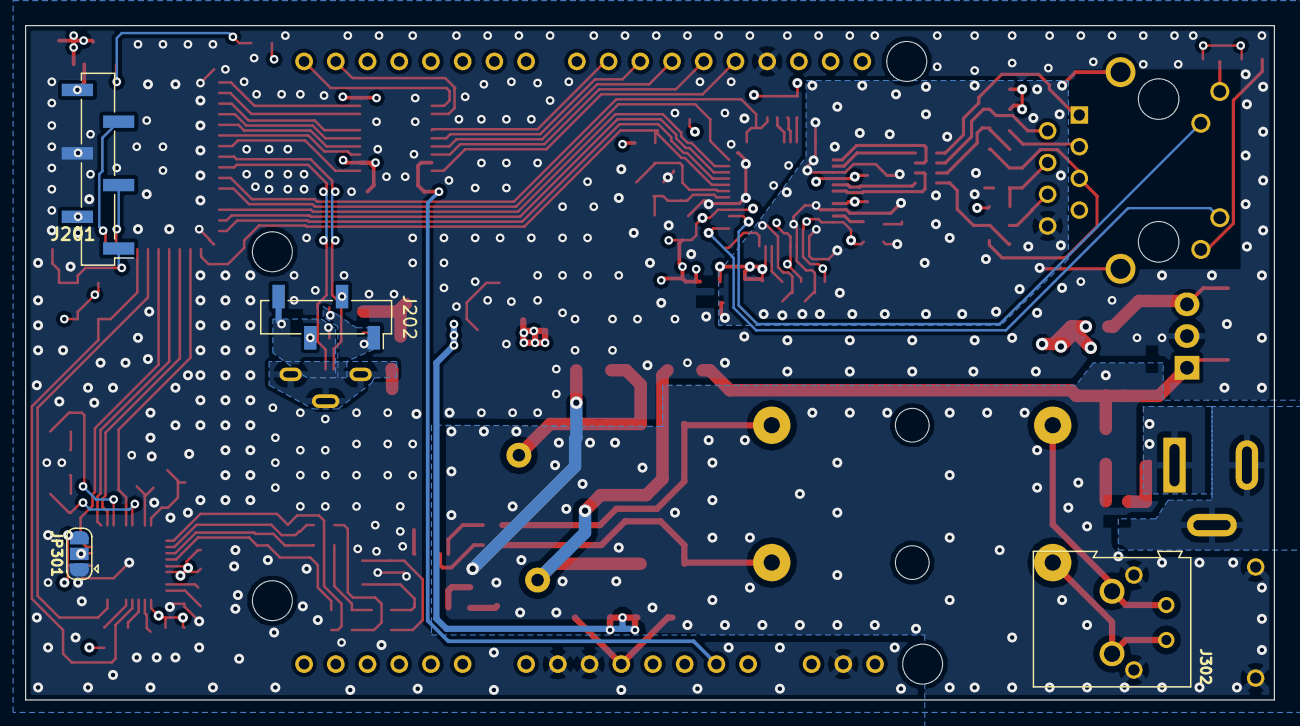
[picture p9: board SinglePair-Eth-Gateway.kicad_pcb from below]

Board: 4 copper layers, 100.0 x 54.0 mm, 119 parts (4 on the bottom side), 106 nets.
