jarojuda/SinglePair-Ethernet-Gateway/(commit log)

2024-01-01 First prototype
    [ADIN1110.kicad_sch, Arduino.kicad_sch, ESP32-S3.kicad_sch, PowerSupply.kicad_sch, SinglePair-Eth-Gateway.kicad_pcb, SinglePair-Eth-Gateway.kicad_sch, W5500.kicad_sch]
2024-01-26 Change position of values on the Fab layer
    [ESP32-S3.kicad_sch, PowerSupply.kicad_sch, SinglePair-Eth-Gateway.csv, SinglePair-Eth-Gateway.kicad_pcb, SinglePair-Eth-Gateway.ods, W5500.kicad_sch]
